dfransiscus/GuM-Stick/Assembly Diagram and Photos/image_0010.jpg

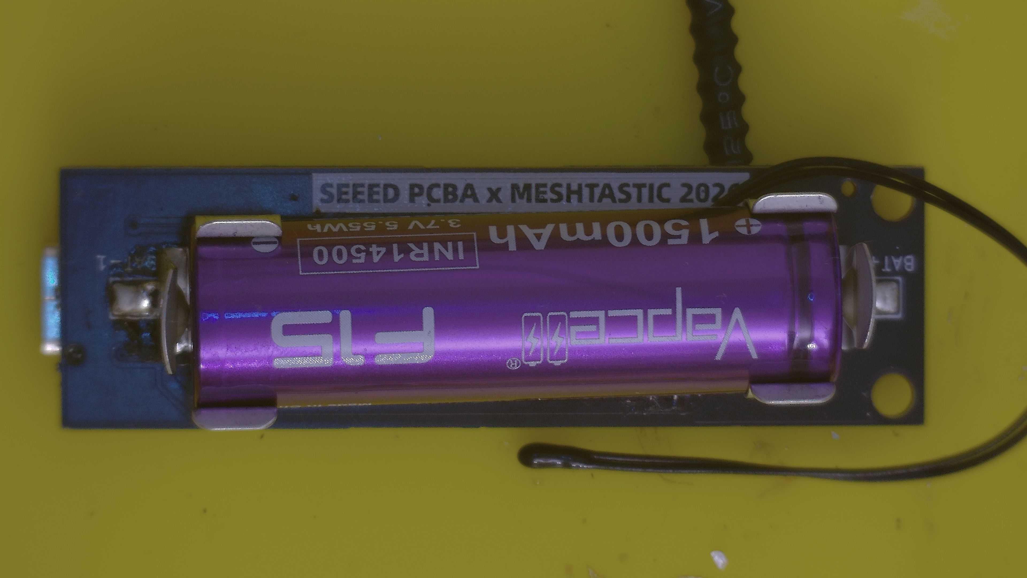
Assembly Diagram and Photos/image_0010.jpg
