dfransiscus/GuM-Stick/Assembly Diagram and Photos/image_0011.jpg

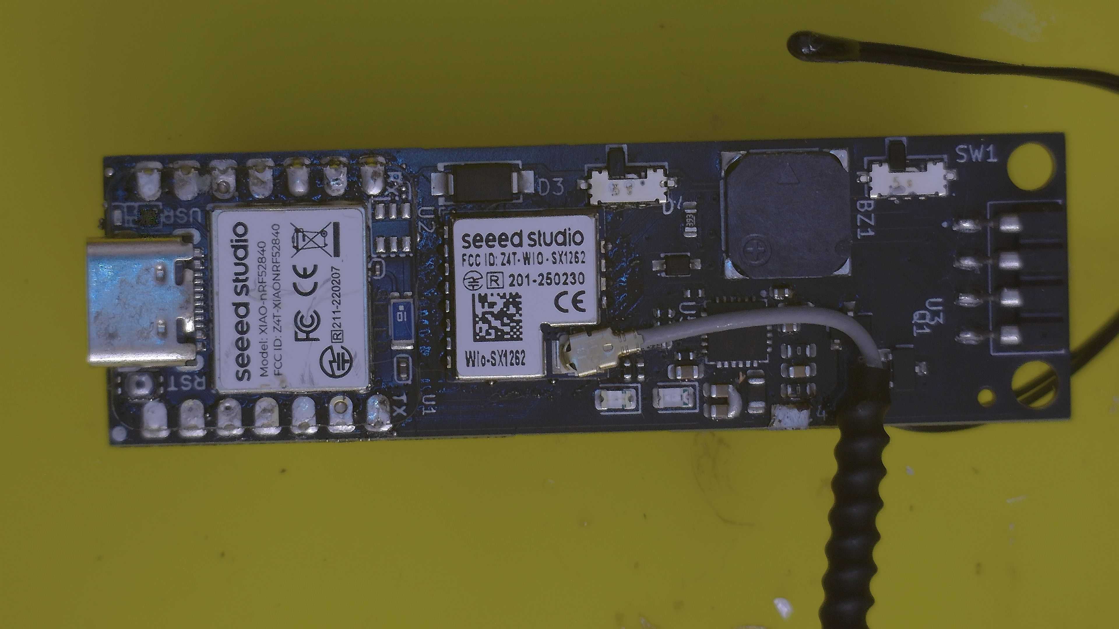
Assembly Diagram and Photos/image_0011.jpg
