dfransiscus/GuM-Stick/Case/GuM Stick Case Bottom.stl

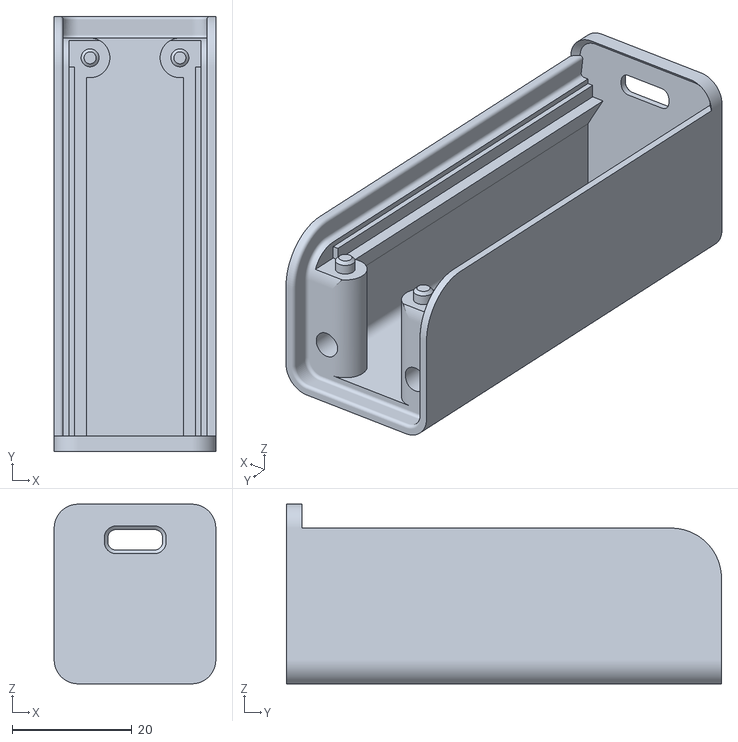
[picture p3: CAD file, 2026-08-07]
Case/GuM Stick Case Bottom.stl
27.0 x 72.7 x 30.0
