dfransiscus/GuM-Stick/Case/GuM Stick Case Top.stl

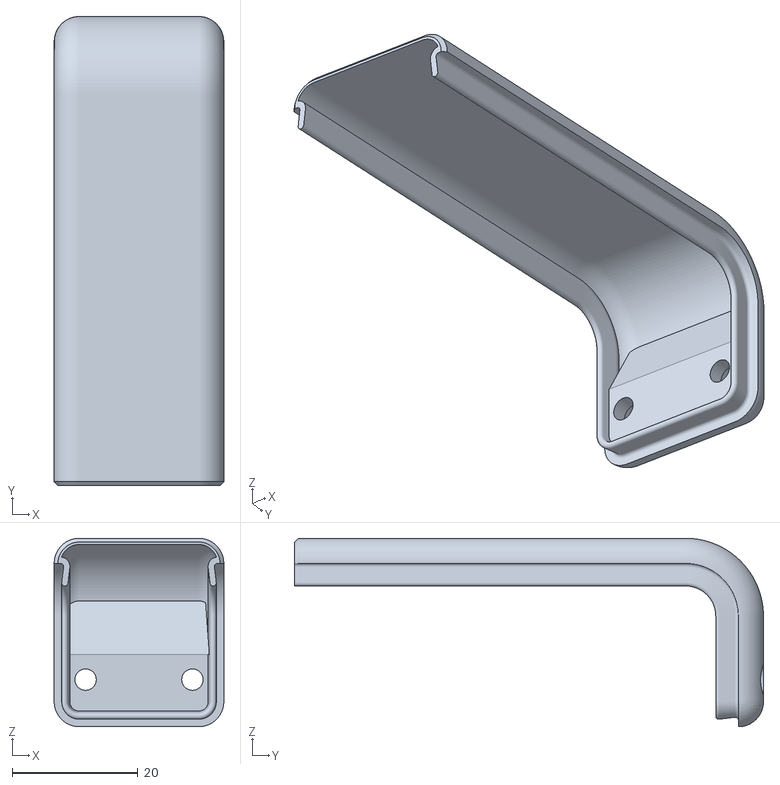
[picture p4: CAD file, 2026-08-07]
Case/GuM Stick Case Top.stl
27.0 x 74.7 x 30.0
