dfransiscus/GuM-Stick/GuMStick.kicad_pcb

## KiCad design GuMStick.kicad_pcb (2026-08-07)

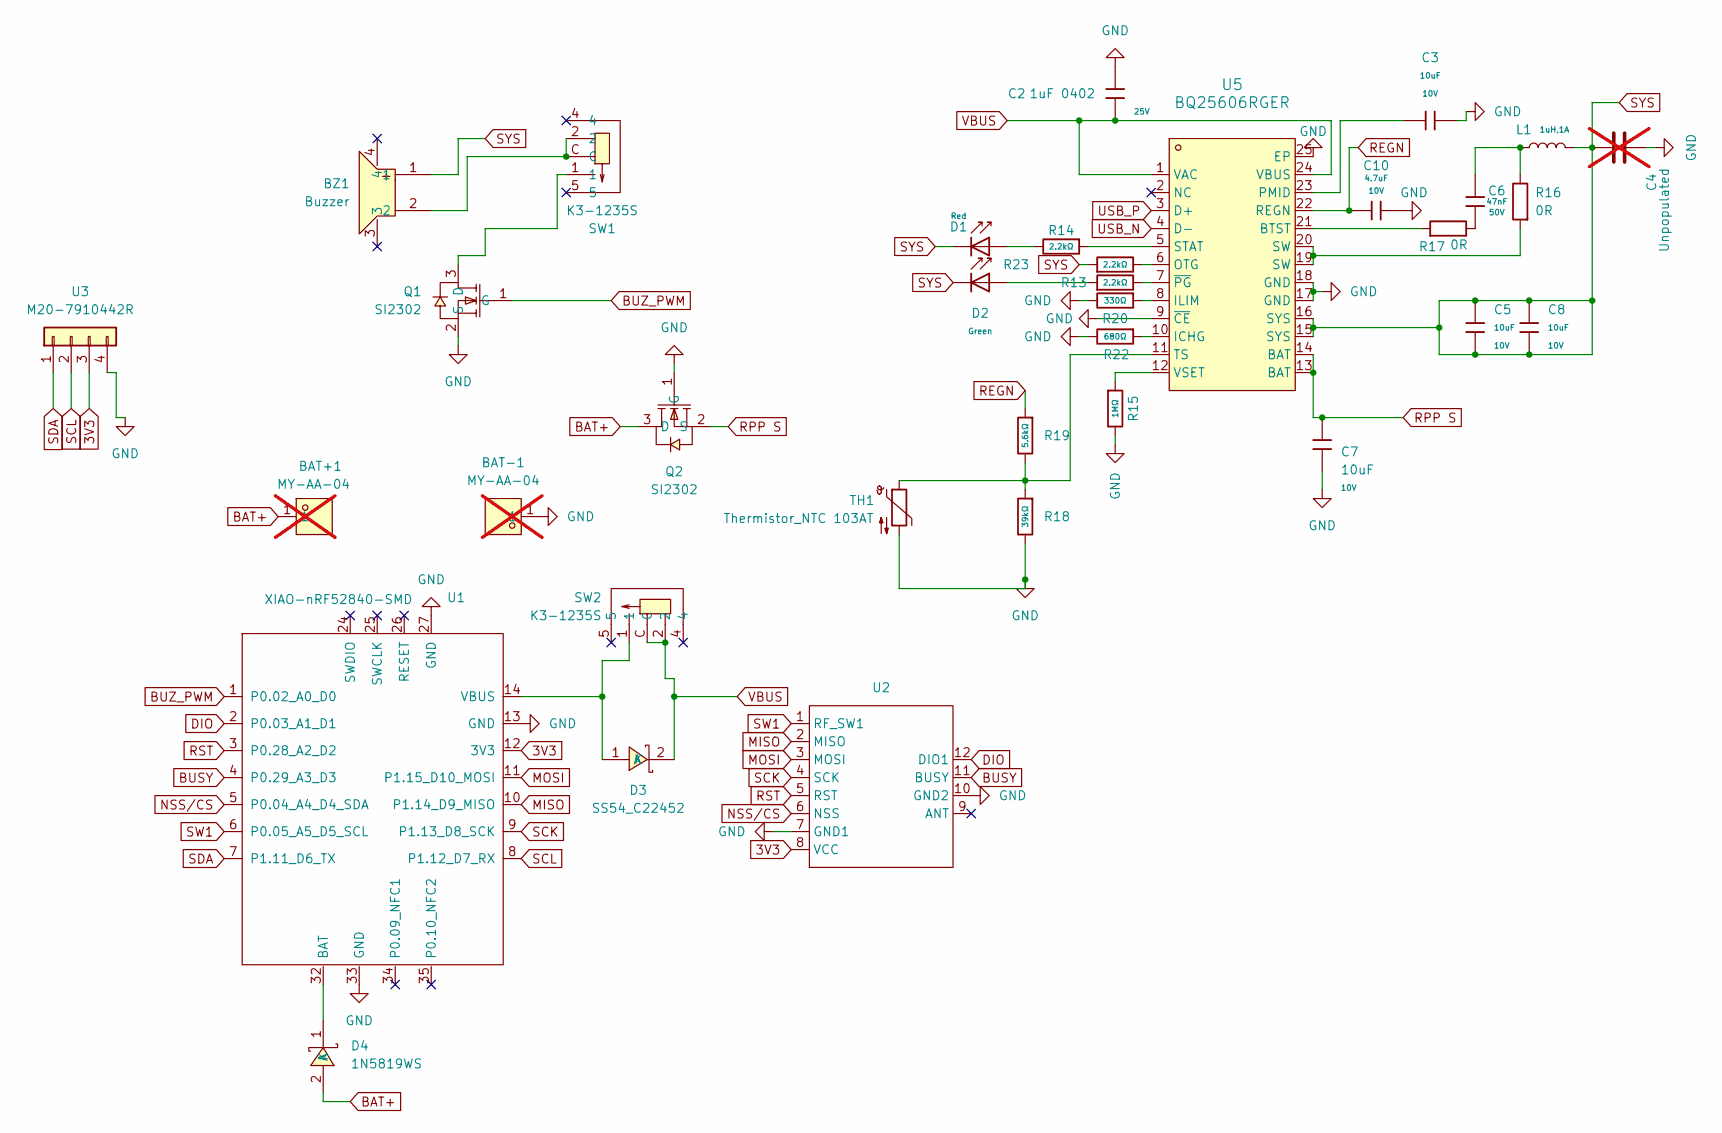
[picture p5: schematic GuMStick.kicad_sch]

Parts:
BAT+1: MY-AA-04; BAT-SMD_MY-AA-04; MPN MY-AA-04; LCSC Part C2979179; not fitted
BAT-1: MY-AA-04; BAT-SMD_MY-AA-04; MPN MY-AA-04; LCSC Part C2979179; not fitted
BZ1: Buzzer; BUZ-SMD_4P-L8.5-W8.5_FUET-8530-05; MPN SMD8530-32Ω; LCSC Part C49246949
C2: 1uF 0402; C_0402; Voltage Rated 25V; Tolerance ±10%; Part CL05A105KA5NQNC; LCSC C52923
C3, C5, C7, C8: 10uF; C_0603; Voltage Rated 10V; Tolerance ±10%; Part CL10A106KP8NNNC; LCSC C19702
C4: Unpopulated; C_0402_1005Metric; not fitted
C6: 47nF; C_0603; Voltage Rated 50V; Tolerance ±10%; Part CL10B473KB8NNNC; LCSC C1622
C10: 4.7uF; C_0402; Voltage Rated 10V; Tolerance ±20%; Part CL05A475MP5NRNC; LCSC C23733
D1: Red; D_0805; Forward Voltage (VF) 1.6V~2.6V; MPN NCD0805R1; LCSC C84256
D2: Green; D_0805; Part KT-0805G; LCSC C2297
D3: SS54_C22452; SMA_L4.4-W2.8-LS5.4-R-RD; MPN SS54; LCSC Part C22452
D4: 1N5819WS; SOD-323_L1.8-W1.3-LS2.5-RD; MPN 1N5819WS; LCSC Part C191023
L1: 1uH,1A; L_0805; Tolerance ±10%; Part YWLD2012-1R0K; LCSC C5339212
Q1, Q2: SI2302; SOT-23_L2.9-W1.3-P1.90-LS2.4-BR; MPN Si2302CDS-T1-GE3; LCSC Part C10488
R13, R14, R23: 2.2kΩ; R_0402; Overload Voltage (Max) 50V; Tolerance ±1%; Part 0402WGF2201TCE; LCSC C25879
R15: 1MΩ; R_0402; Overload Voltage (Max) 50V; Tolerance ±1%; Part 0402WGF1004TCE; LCSC C26083
R16, R17: 0R; R_0603; Overload Voltage (Max) 75V; Tolerance ±1%; Part 0603WAF0000T5E; LCSC C21189
R18: 39kΩ; R_0603; Overload Voltage (Max) 75V; Tolerance ±1%; Part 0603WAF3902T5E; LCSC C23153
R19: 5.6kΩ; R_0603; Overload Voltage (Max) 75V; Tolerance ±1%; Part 0603WAF5601T5E; LCSC C23189
R20: 330Ω; R_0402; Overload Voltage (Max) 50V; Tolerance ±1%; Part 0402WGF3300TCE; LCSC C25104
R22: 680Ω; R_0402; Overload Voltage (Max) 50V; Tolerance ±1%; Part 0402WGF6800TCE; LCSC C25130
SW1, SW2: K3-1235S; SW-SMD_MK-11C04-G013; MPN MK-11C04-G013; LCSC Part C778185
TH1: Thermistor_NTC 103AT; PinHeader_1x02_P2.00mm_Vertical; MPN 103AT-4-70374
U1: XIAO-nRF52840-SMD; MPN 102010448
U2: Wio-SX1262; Wio SX1262; MPN Wio-SX1262
U3: M20-7910442R; MF254RS-11-04-0743 XFCN 4 Pin Machined Header; MPN MF254RS-11-04-0743
U5: BQ25606RGER; VQFN-24_L4.0-W4.0-P0.50-TL-EP2.8; MPN BQ25606RGER; LCSC Part C374063

Connections:
3V3: U1.12 (3V3), U2.8 (VCC), U3.3
BAT+: BAT+1.1 (1_1), D4.2 (A), Q2.3 (D)
BUSY: U1.4 (P0.29_A3_D3), U2.11 (BUSY)
BUZ_PWM: Q1.1 (G), U1.1 (P0.02_A0_D0)
DIO: U1.2 (P0.03_A1_D1), U2.12 (DIO1)
GND: BAT-1.1 (1_1), C2.2, C3.1, C4.1, C7.2, C10.2, Q1.2 (S), Q2.1 (G), R15.2, R18.2, R20.2, R22.2, TH1.2, U1.13 (GND), U1.27 (GND), U1.33 (GND), U2.7 (GND1), U2.10 (GND2), U3.4, U5.9 (~CE), U5.17 (GND), U5.18 (GND), U5.25 (EP)
MISO: U1.10 (P1.14_D9_MISO), U2.2 (MISO)
MOSI: U1.11 (P1.15_D10_MOSI), U2.3 (MOSI)
NSS/CS: U1.5 (P0.04_A4_D4_SDA), U2.6 (NSS)
unnamed: BZ1.2, SW1.2, SW1.C
unnamed: C6.1, L1.1, R16.2
unnamed: C6.2, R17.2
unnamed: D1.2, R14.2
unnamed: D2.2, R13.1
unnamed: D3.1 (A), SW2.1, U1.14 (VBUS)
unnamed: D4.1 (K), U1.32 (BAT)
unnamed: Q1.3 (D), SW1.1
unnamed: R16.1, U5.19 (SW), U5.20 (SW)
unnamed: R17.1, U5.21 (BTST)
unnamed: R22.1, U5.10 (ICHG)
unnamed: R20.1, U5.8 (ILIM)
unnamed: R23.2, U5.6 (OTG)
unnamed: C3.2, U5.23 (PMID)
unnamed: R14.1, U5.5 (STAT)
unnamed: R18.1, R19.2, TH1.1, U5.11 (TS)
unnamed: R15.1, U5.12 (VSET)
unnamed: R13.2, U5.7 (~PG)
REGN: C10.1, R19.1, U5.22 (REGN)
RPP S: C7.1, Q2.2 (S), U5.13 (BAT), U5.14 (BAT)
RST: U1.3 (P0.28_A2_D2), U2.5 (RST)
SCK: U1.9 (P1.13_D8_SCK), U2.4 (SCK)
SCL: U1.8 (P1.12_D7_RX), U3.2
SDA: U1.7 (P1.11_D6_TX), U3.1
SW1: U1.6 (P0.05_A5_D5_SCL), U2.1 (RF_SW1)
SYS: BZ1.1, C4.2, C5.1, C5.2, C8.1, C8.2, D1.1, D2.1, L1.2, R23.1, U5.15 (SYS), U5.16 (SYS)
USB_N: U5.4 (D-)
USB_P: U5.3 (D+)
VBUS: C2.1, D3.2 (K), SW2.2, SW2.C, U5.1 (VAC), U5.24 (VBUS)

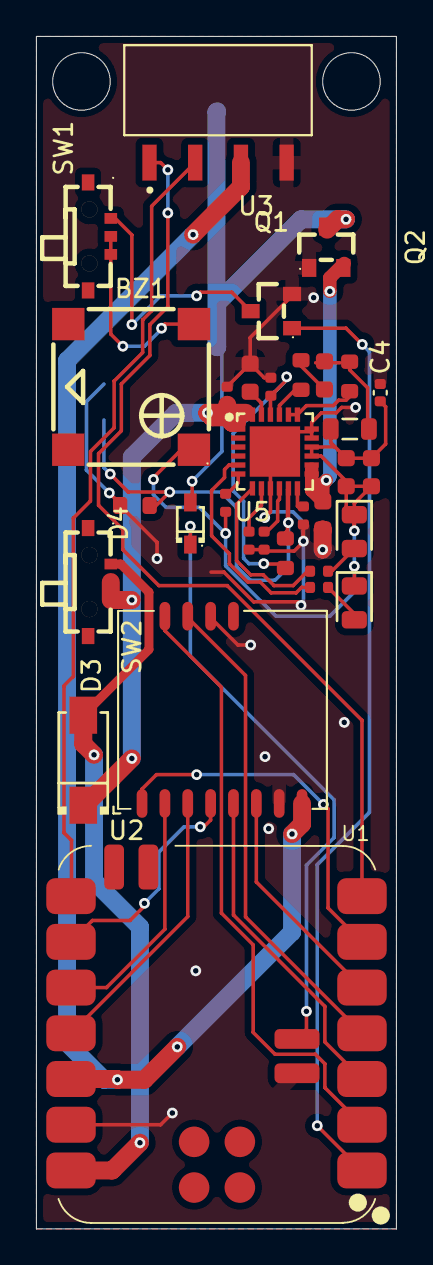
[picture p6: board GuMStick.kicad_pcb from above]

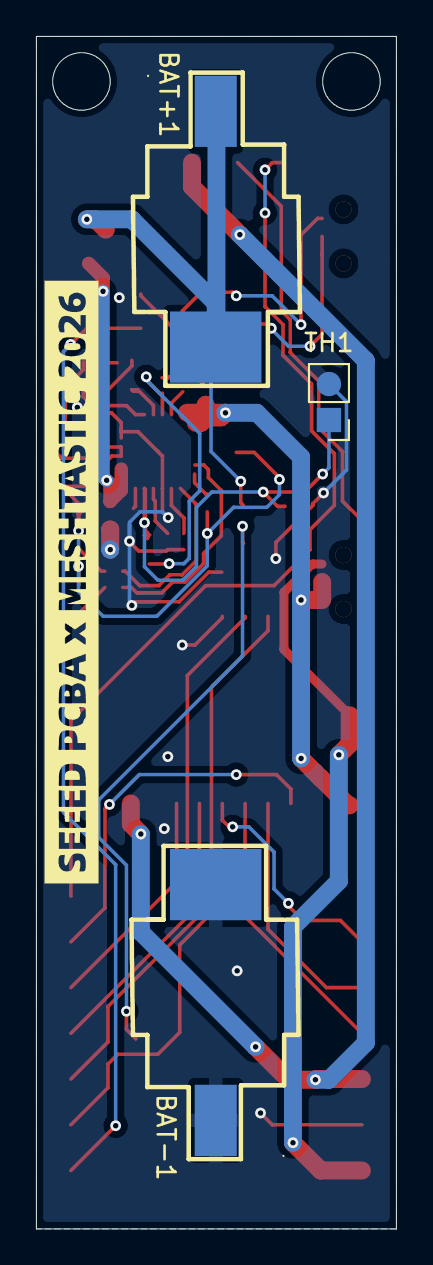
[picture p7: board GuMStick.kicad_pcb from below]

Board: 2 copper layers, 20.0 x 66.2 mm, 35 parts (3 on the bottom side), 36 nets.
