dfransiscus/GuM-Stick/Assembly Diagram and Photos/Assembled GuMStick.jpeg

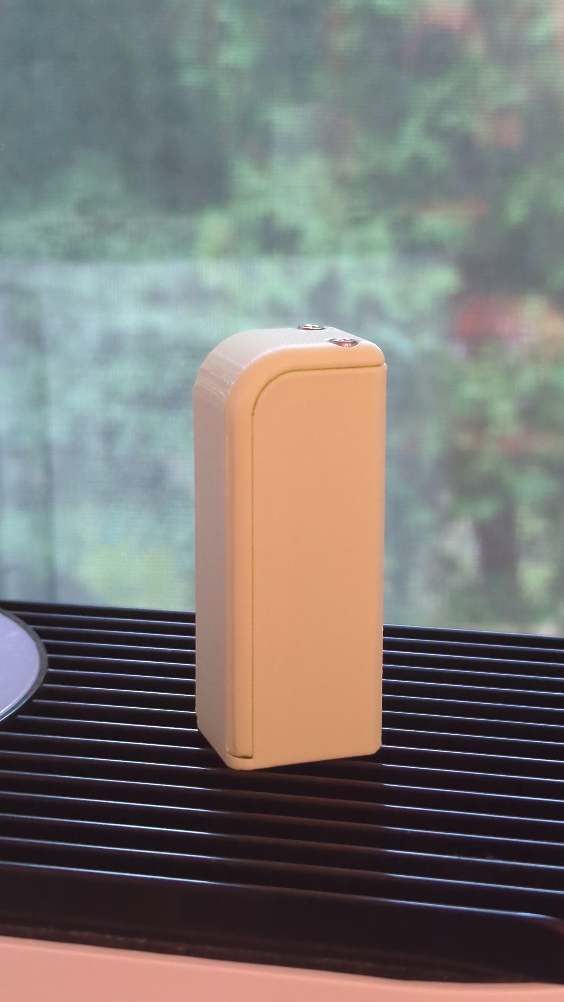
Assembly Diagram and Photos/Assembled GuMStick.jpeg
