dfransiscus/GuM-Stick/Assembly Diagram and Photos/image_0012.jpg

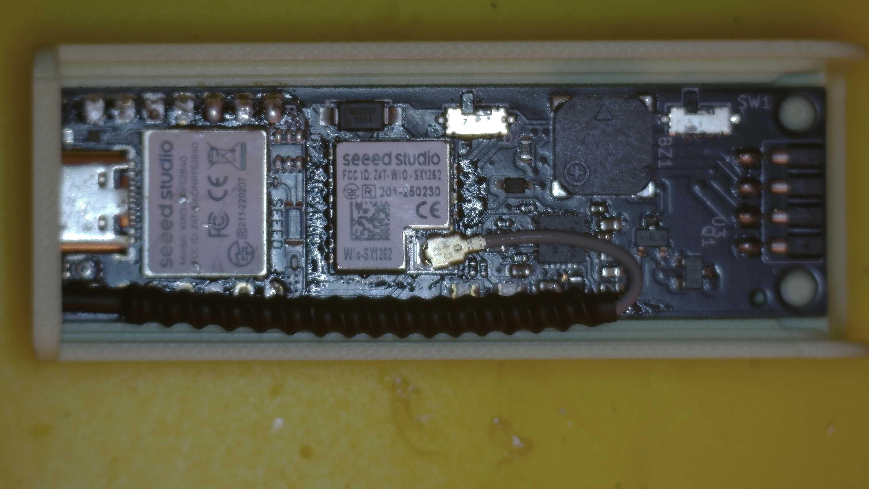
Assembly Diagram and Photos/image_0012.jpg
