dfransiscus/GuM-Stick/(commit log)

2026-06-24 Update file names, add Seeed X Meshtastic silkscreen
    [GuMStick.kicad_pcb, GuMStick.kicad_sch]
2026-06-26 Schematic changes, PCB changes not yet complete. Removed error with debounce capacitor in series with Bat+, should have been parallel, prevented system from working. Added a second mosfet for reverse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
    [GuMStick.kicad_pcb, GuMStick.kicad_sch]
2026-07-22 PCB updated to include reverse polarity protection via MOSFET, added diode to battery pin on XIAO to allow battery voltage detection without allowing charging.
    [GuMStick.kicad_pcb, GuMStick.kicad_sch]
2026-07-23 Removed 180R on buzzer
    [GuMStick.kicad_pcb, GuMStick.kicad_sch]
2026-07-23 Fixes to part numbers and details
    [GuMStick.kicad_pcb, GuMStick.kicad_sch]
2026-08-07 Updating to current builds. Firmware has base messaging functionality. Buzzer still presents issues, possibly due to the capacitor/inductor setup on SYS as the D0 pin should turn on the mosfet to put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
    [GuMStick.kicad_pcb]
2026-08-07 More photos, updates, BOM, Case files
    [GuM Stick Case Bottom.stl, GuM Stick Case Top.stl, bom.csv]
